sectersion/KernelPanic/reference/trellis_core/assets/pcb_render.png

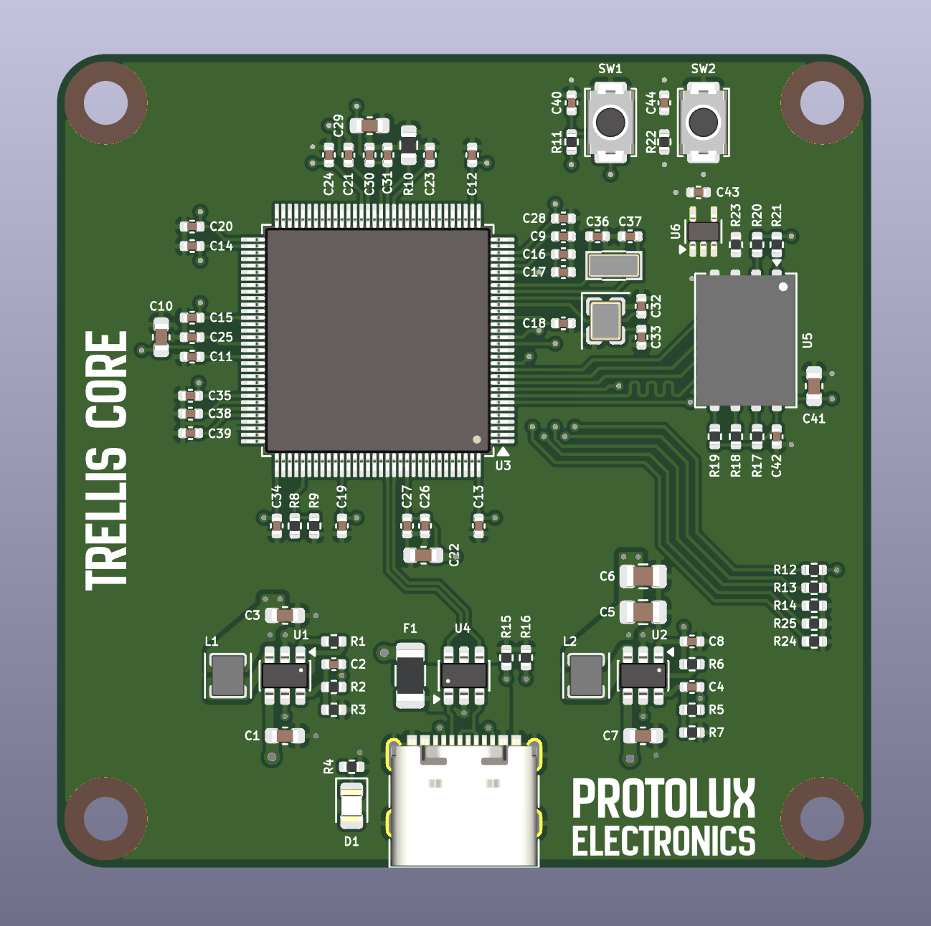
reference/trellis_core/assets/pcb_render.png
