sectersion/KernelPanic/reference/trellis_core/3dmodels/LGA8.step

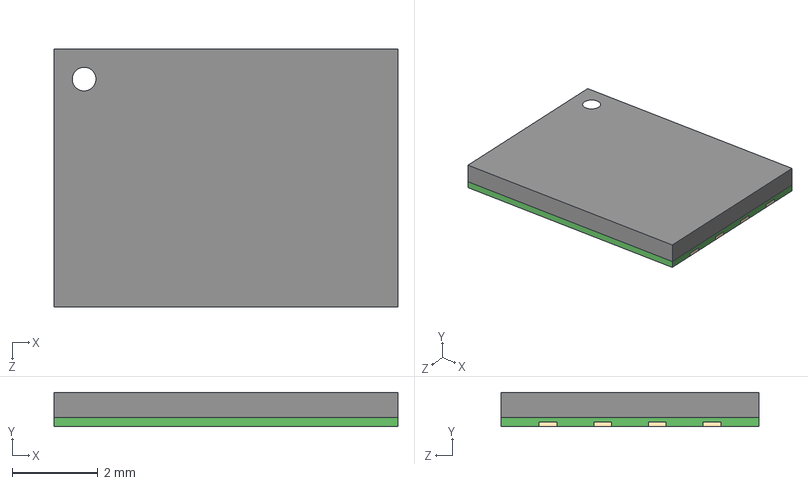
[picture p3: CAD file, 2026-10-30]
reference/trellis_core/3dmodels/LGA8.step
8.00 x 0.8 x 6.00 mm
