sectersion/KernelPanic/reference/trellis_core/src/trellis_core.kicad_pcb

## KiCad design reference/trellis_core/src/trellis_core.kicad_pcb (2026-10-30)

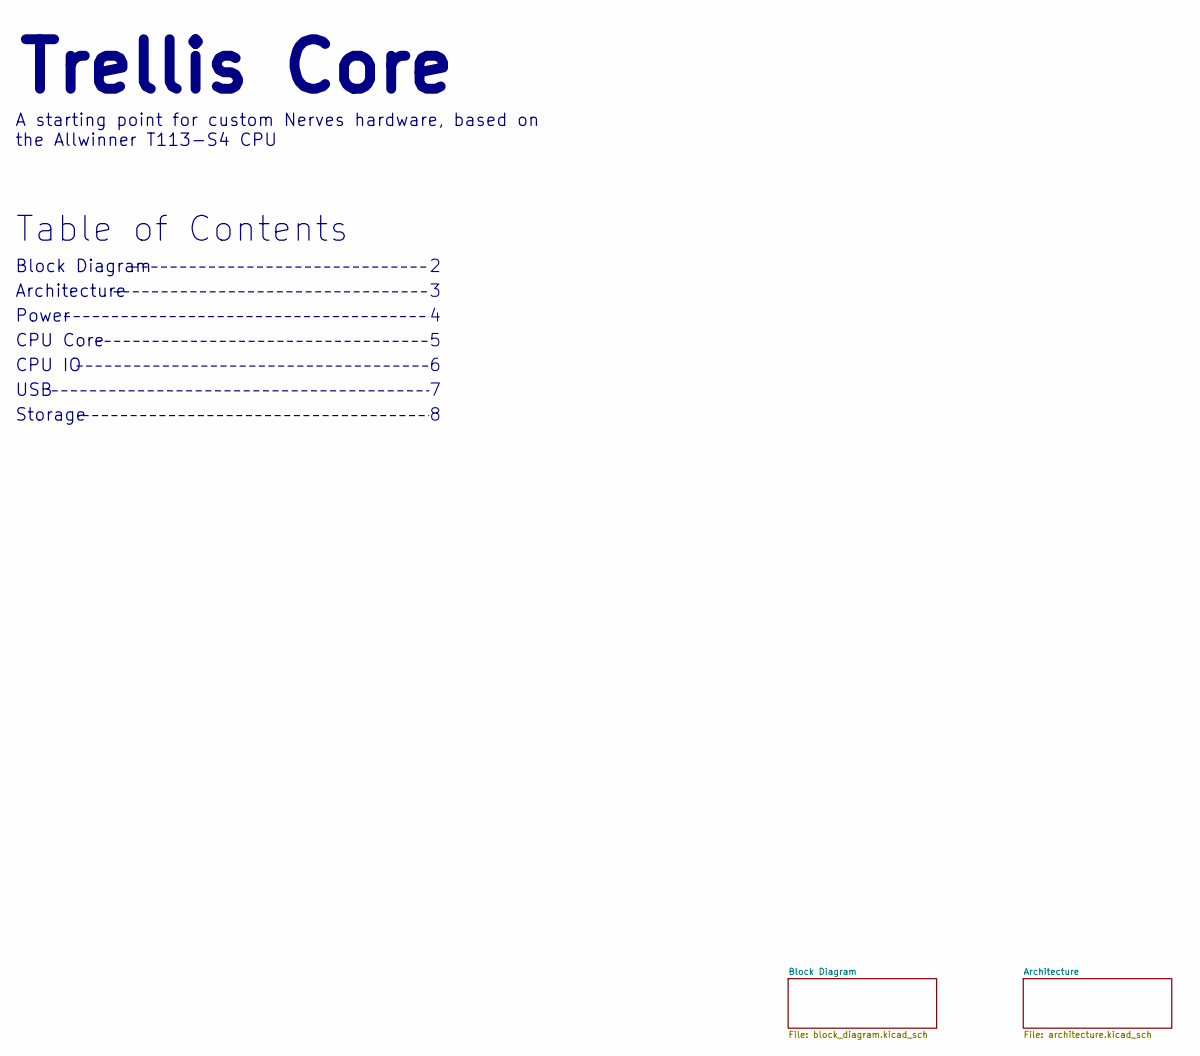
[picture p4: schematic trellis_core.kicad_sch, Trellis Core]

Notes on the sheet:
Table of Contents
Trellis Core
A starting point for custom Nerves hardware, based on the Allwinner T113-S4 CPU
Block Diagram
Architecture
CPU IO
Storage
Power
CPU Core
USB

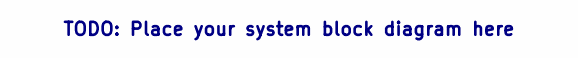
[picture p5: schematic block_diagram.kicad_sch, Trellis Core]

Notes on the sheet:
TODO: Place your system block diagram here

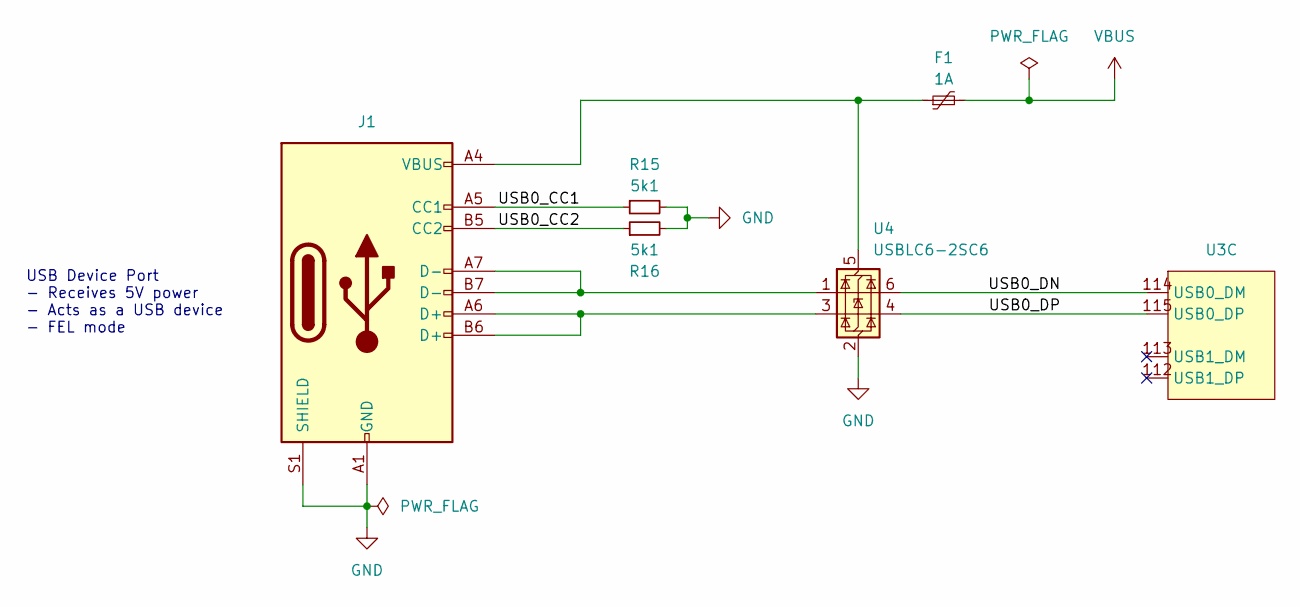
[picture p6: schematic usb.kicad_sch, Trellis Core]

Parts:
F1: 1A; Fuse_1206_3216Metric; MPN JK-nSMD100-16; LCSC C369161
J1: USB_C_Receptacle_USB2.0_14P; USB_C_Receptacle_G-Switch_GT-USB-7010ASV; MPN HX TYPE-C 16P L8.35; LCSC C41427493
R15, R16: 5k1; R_0402_1005Metric; MPN 0402WGF5101TCE; LCSC C25905
U3: T113-S3; T113-S4; MPN T113M4020DC0; LCSC C41411351
U4: USBLC6-2SC6; SOT-23-6; MPN USBLC6-2SC6; LCSC C2827654

Connections:
/Architecture/USB/USB0_CC1: J1.A5 (CC1), R15.1
/Architecture/USB/USB0_CC2: J1.B5 (CC2), R16.1
/Architecture/USB/USB0_DN: U3.114 (USB0_DM), U4.6 (I/O1)
/Architecture/USB/USB0_DP: U3.115 (USB0_DP), U4.4 (I/O2)
GND: J1.A1 (GND), J1.A12 (GND), J1.B1 (GND), J1.B12 (GND), J1.S1 (SHIELD), R15.2, R16.2, U4.2 (GND); also elsewhere on the board
unnamed: J1.A6 (D+), J1.B6 (D+), U4.3 (I/O2)
unnamed: J1.A7 (D-), J1.B7 (D-), U4.1 (I/O1)
unnamed: F1.1, J1.A4 (VBUS), J1.A9 (VBUS), J1.B4 (VBUS), J1.B9 (VBUS), U4.5 (VBUS)
VBUS: F1.2; also elsewhere on the board

Notes on the sheet:
USB Device Port - Receives 5V power - Acts as a USB device - FEL mode

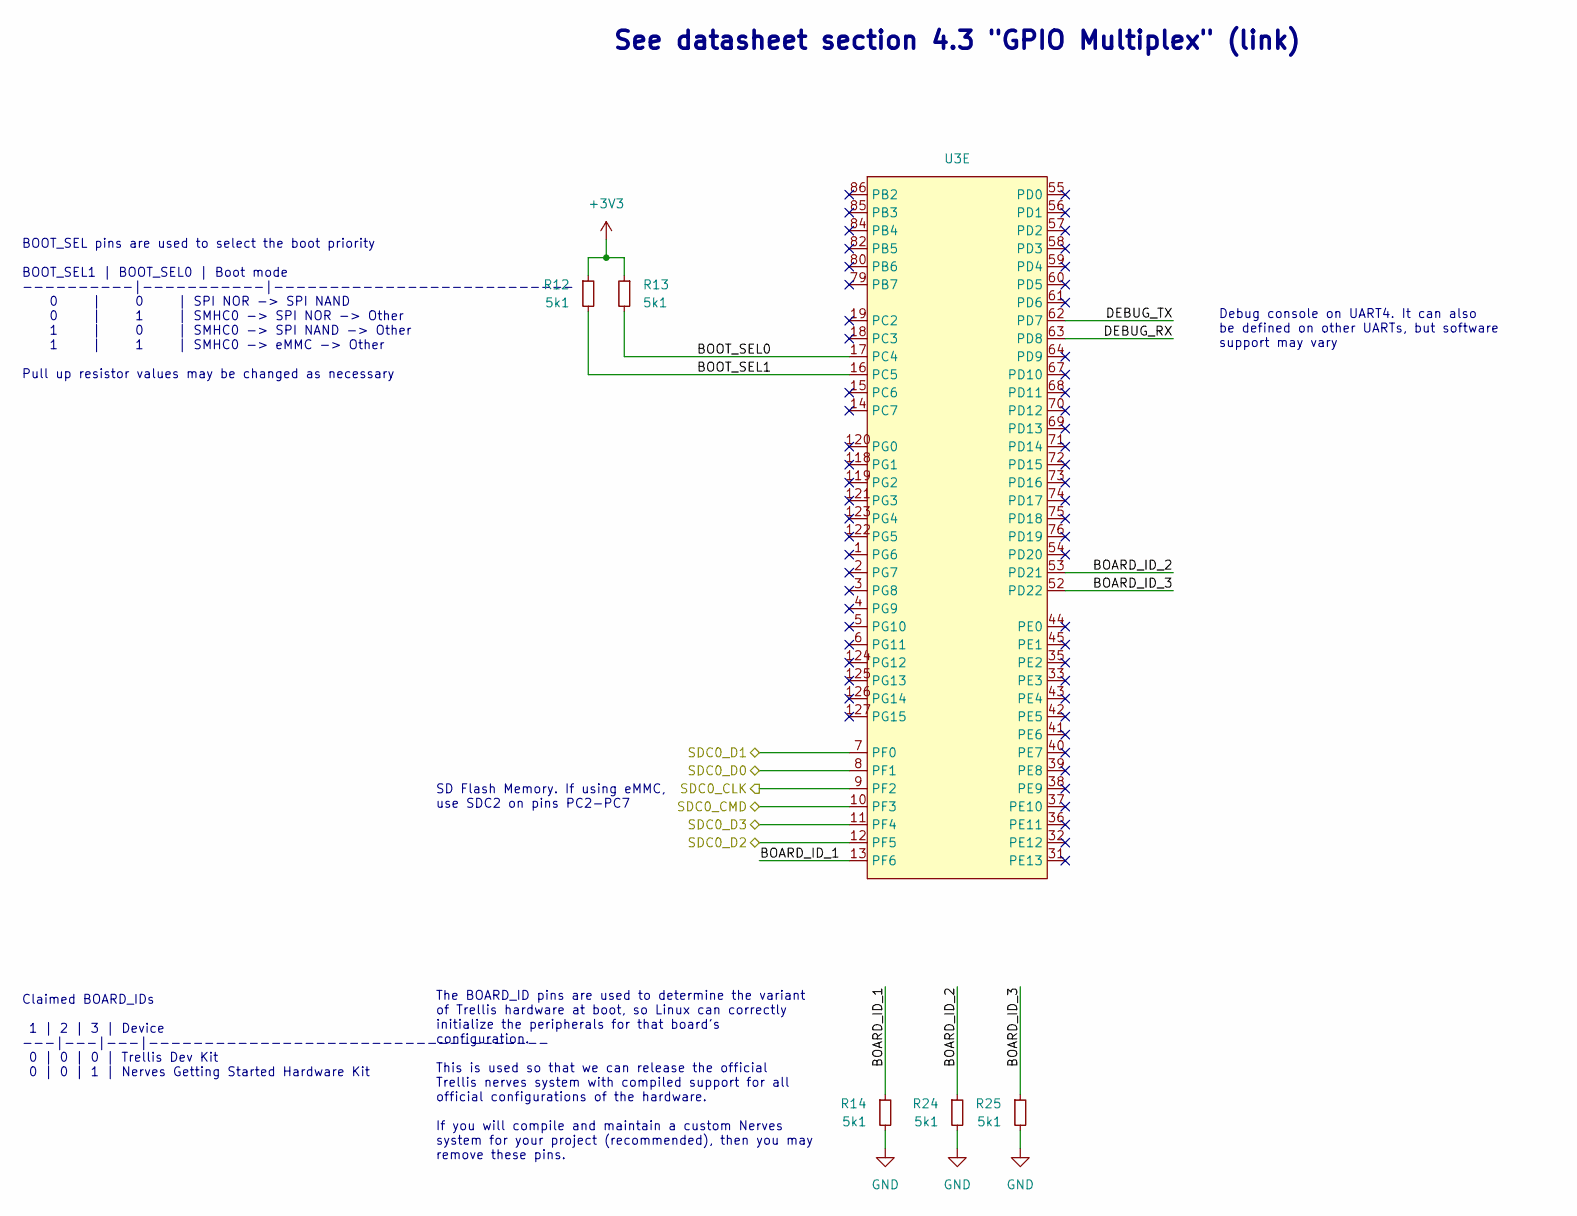
[picture p7: schematic cpu_io.kicad_sch, Trellis Core]

Parts:
R12, R13, R14, R24, R25: 5k1; R_0402_1005Metric; MPN 0402WGF5101TCE; LCSC C25905
U3: T113-S3; MPN T113M4020DC0; LCSC C41411351

Connections:
+3V3: R12.1, R13.1; also elsewhere on the board
/Architecture/CPU IO/BOARD_ID_1: R14.1, U3.13 (PF6)
/Architecture/CPU IO/BOARD_ID_2: R24.1, U3.53 (PD21)
/Architecture/CPU IO/BOARD_ID_3: R25.1, U3.52 (PD22)
/Architecture/CPU IO/BOOT_SEL0: R13.2, U3.17 (PC4)
/Architecture/CPU IO/BOOT_SEL1: R12.2, U3.16 (PC5)
/Architecture/CPU IO/DEBUG_RX: U3.63 (PD8)
/Architecture/CPU IO/DEBUG_TX: U3.62 (PD7)
/Architecture/CPU IO/SDC0_CLK: U3.9 (PF2); also elsewhere on the board
/Architecture/CPU IO/SDC0_CMD: U3.10 (PF3); also elsewhere on the board
/Architecture/CPU IO/SDC0_D0: U3.8 (PF1); also elsewhere on the board
/Architecture/CPU IO/SDC0_D1: U3.7 (PF0); also elsewhere on the board
/Architecture/CPU IO/SDC0_D2: U3.12 (PF5); also elsewhere on the board
/Architecture/CPU IO/SDC0_D3: U3.11 (PF4); also elsewhere on the board
GND: R14.2, R24.2, R25.2; also elsewhere on the board

Notes on the sheet:
The BOARD_ID pins are used to determine the variant of Trellis hardware at boot, so Linux can correctly initialize the peripherals for that board's configuration. This is used so that we can release the official Trellis nerves system with compiled support for all official configurations of the hard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
SD Flash Memory. If using eMMC, use SDC2 on pins PC2-PC7
Debug console on UART4. It can also be defined on other UARTs, but software support may vary
BOOT_SEL pins are used to select the boot priority BOOT_SEL1 | BOOT_SEL0 | Boot mode ----------|-----------|--------------------------- 0 | 0 | SPI NOR -> SPI NAND 0 | 1 | SMHC0 -> SPI NOR -> Other 1 | 0 | SMHC0 -> SPI NAND -> Other 1 | 1 | SMHC0 -> eMMC -> Other Pull up resistor values may be chan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
Claimed BOARD_IDs 1 | 2 | 3 | Device ---|---|---|------------------------------------ 0 | 0 | 0 | Trellis Dev Kit 0 | 0 | 1 | Nerves Getting Started Hardware Kit
See datasheet section 4.3 "GPIO Multiplex" (link)

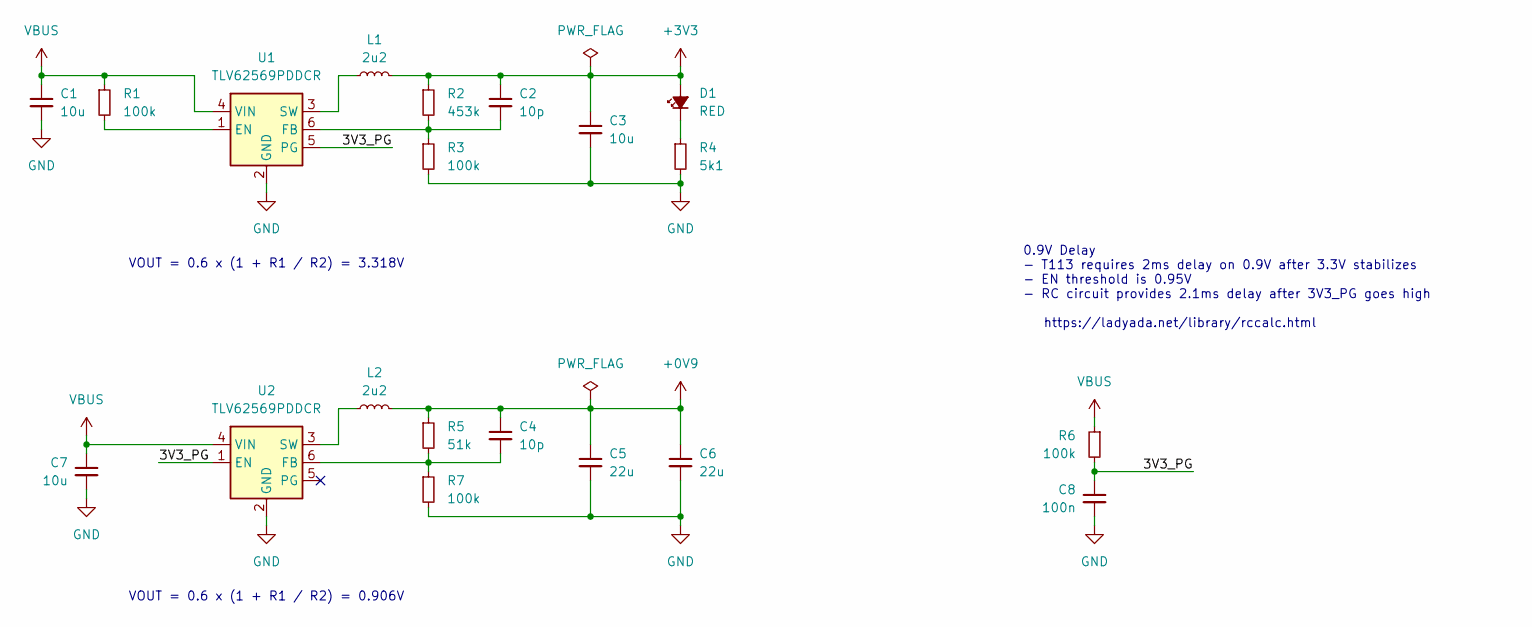
[picture p8: schematic power.kicad_sch, Trellis Core]

Parts:
C1, C3, C7: 10u; C_0603_1608Metric; MPN CL10A106MA8NRNC; LCSC C96446
C2, C4: 10p; C_0402_1005Metric; MPN CL05C100JB5NNNC; LCSC C32949
C5, C6: 22u; C_0805_2012Metric; MPN CL21A226MAQNNNE; LCSC C45783
C8: 100n; C_0402_1005Metric; MPN CL05B104KB54PNC; LCSC C307331
D1: RED; LED_0805_2012Metric; MPN NCD0805R1; LCSC C84256
L1, L2: 2u2; L_Wuerth_MAPI-2510; MPN XRIM252012S2R2MBCA; LCSC C22471111
R1, R3, R6, R7: 100k; R_0402_1005Metric; MPN 0402WGF1003TCE; LCSC C25741
R2: 453k; R_0402_1005Metric; MPN 0402WGF4533TCE; LCSC C27009
R4: 5k1; R_0402_1005Metric; MPN 0402WGF5101TCE; LCSC C25905
R5: 51k; R_0402_1005Metric; MPN 0402WGF5102TCE; LCSC C25794
U1, U2: TLV62569PDDCR; SOT-23-6; MPN TLV62569PDDCR; LCSC C398365

Connections:
+0V9: C4.1, C5.1, C6.1, L2.2, R5.1; also elsewhere on the board
+3V3: C2.1, C3.1, D1.2 (A), L1.2, R2.1; also elsewhere on the board
/Architecture/Power/3V3_PG: C8.1, R6.2, U1.5 (PG), U2.1 (EN)
GND: C1.2, C3.2, C5.2, C6.2, C7.2, C8.2, R3.2, R4.2, R7.2, U1.2 (GND), U2.2 (GND); also elsewhere on the board
unnamed: D1.1 (K), R4.1
unnamed: R1.2, U1.1 (EN)
unnamed: C2.2, R2.2, R3.1, U1.6 (FB)
unnamed: L1.1, U1.3 (SW)
unnamed: C4.2, R5.2, R7.1, U2.6 (FB)
unnamed: L2.1, U2.3 (SW)
VBUS: C1.1, C7.1, R1.1, R6.1, U1.4 (VIN), U2.4 (VIN); also elsewhere on the board

Notes on the sheet:
VOUT = 0.6 x (1 + R1 / R2) = 3.318V
0.9V Delay - T113 requires 2ms delay on 0.9V after 3.3V stabilizes - EN threshold is 0.95V - RC circuit provides 2.1ms delay after 3V3_PG goes high https://ladyada.net/library/rccalc.html
VOUT = 0.6 x (1 + R1 / R2) = 0.906V

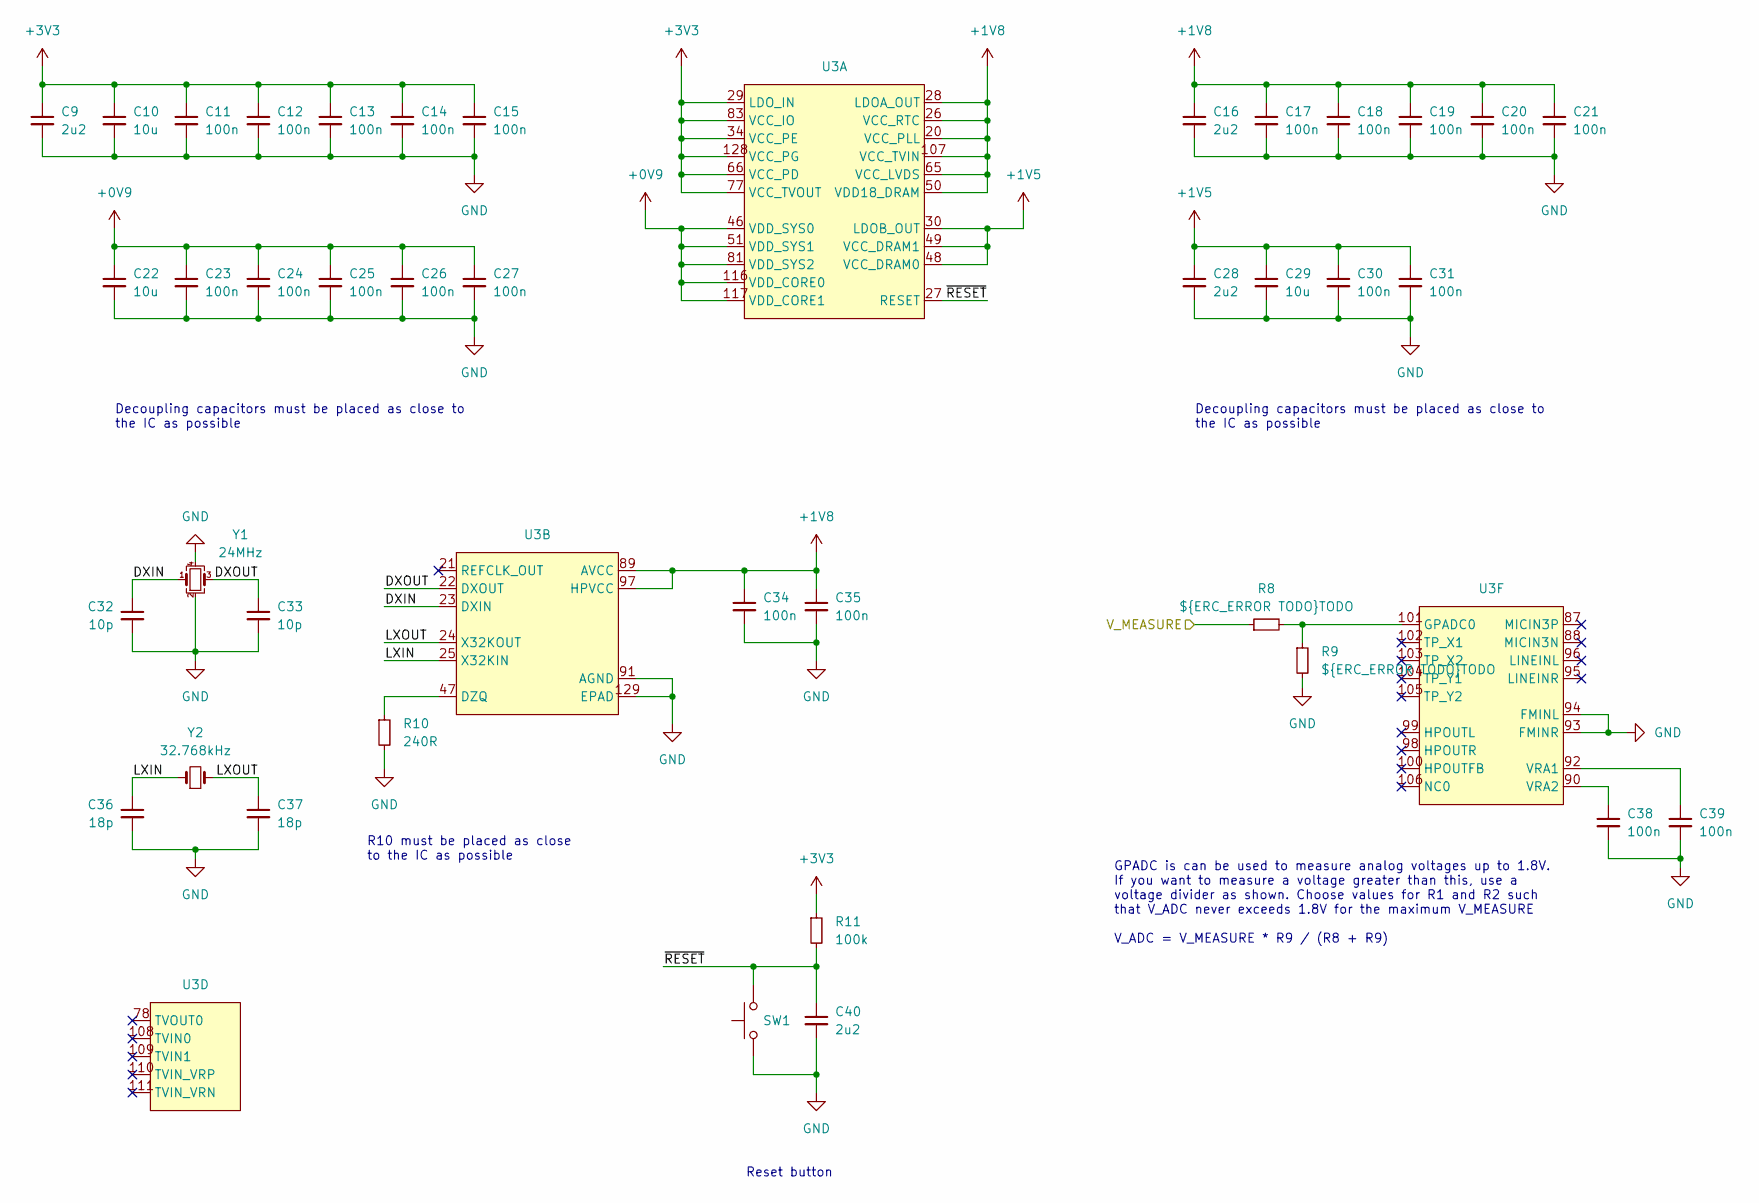
[picture p9: schematic cpu_core.kicad_sch, Trellis Core]

Parts:
C9, C16, C28, C40: 2u2; C_0402_1005Metric; MPN CL05A225MQ5NSNC; LCSC C12530
C10, C22, C29: 10u; C_0603_1608Metric; MPN CL10A106MA8NRNC; LCSC C96446
C11, C12, C13, C14, C15, C17, C18, C19, C20, C21, C23, C24, C25, C26, C27, C30, C31, C34, C35, C38, C39: 100n; C_0402_1005Metric; MPN CL05B104KB54PNC; LCSC C307331
C32, C33: 10p; C_0402_1005Metric; MPN CL05C100JB5NNNC; LCSC C32949
C36, C37: 18p; C_0402_1005Metric; MPN 0402CG180J500NT; LCSC C1549
R8, R9: ${ERC_ERROR TODO}TODO; R_0402_1005Metric
R10: 240R; R_0603_1608Metric; MPN 0603WAF2400T5E; LCSC C23350
R11: 100k; R_0402_1005Metric; MPN 0402WGF1003TCE; LCSC C25741
SW1: SW_Push; SW_Push_SPST_NO_Alps_SKRK; MPN TSA010A2026B; LCSC C2888420
U3: T113-S3; MPN T113M4020DC0; LCSC C41411351
Y1: 24MHz; Crystal_SMD_2520-4Pin_2.5x2.0mm; MPN CM4024M00008001; LCSC C7294624
Y2: 32.768kHz; Crystal_SMD_3215-2Pin_3.2x1.5mm; MPN Q13FC13500004; LCSC C32346

Connections:
+0V9: C22.1, C23.1, C24.1, C25.1, C26.1, C27.1, U3.46 (VDD_SYS0), U3.51 (VDD_SYS1), U3.81 (VDD_SYS2), U3.116 (VDD_CORE0), U3.117 (VDD_CORE1); also elsewhere on the board
+1V5: C28.1, C29.1, C30.1, C31.1, U3.30 (LDOB_OUT), U3.48 (VCC_DRAM0), U3.49 (VCC_DRAM1)
+1V8: C16.1, C17.1, C18.1, C19.1, C20.1, C21.1, C34.1, C35.1, U3.20 (VCC_PLL), U3.26 (VCC_RTC), U3.28 (LDOA_OUT), U3.50 (VDD18_DRAM), U3.65 (VCC_LVDS), U3.89 (AVCC), U3.97 (HPVCC), U3.107 (VCC_TVIN)
+3V3: C9.1, C10.1, C11.1, C12.1, C13.1, C14.1, C15.1, R11.1, U3.29 (LDO_IN), U3.34 (VCC_PE), U3.66 (VCC_PD), U3.77 (VCC_TVOUT), U3.83 (VCC_IO), U3.128 (VCC_PG); also elsewhere on the board
/Architecture/CPU Core/DXIN: C32.1, U3.23 (DXIN), Y1.1
/Architecture/CPU Core/DXOUT: C33.1, U3.22 (DXOUT), Y1.3
/Architecture/CPU Core/LXIN: C36.1, U3.25 (X32KIN), Y2.1
/Architecture/CPU Core/LXOUT: C37.1, U3.24 (X32KOUT), Y2.2
/Architecture/CPU Core/V_MEASURE: R8.1
/Architecture/CPU Core/~RESET: C40.1, R11.2, SW1.2, U3.27 (RESET)
GND: C9.2, C10.2, C11.2, C12.2, C13.2, C14.2, C15.2, C16.2, C17.2, C18.2, C19.2, C20.2, C21.2, C22.2, C23.2, C24.2, C25.2, C26.2, C27.2, C28.2, C29.2, C30.2, C31.2, C32.2, C33.2, C34.2, C35.2, C36.2, C37.2, C38.2, C39.2, C40.2, R9.2, R10.2, SW1.1, U3.91 (AGND), U3.93 (FMINR), U3.94 (FMINL), U3.129 (EPAD), Y1.2, Y1.4; also elsewhere on the board
unnamed: R10.1, U3.47 (DZQ)
unnamed: R8.2, R9.1, U3.101 (GPADC0)
unnamed: C39.1, U3.92 (VRA1)
unnamed: C38.1, U3.90 (VRA2)

Notes on the sheet:
Reset button
Decoupling capacitors must be placed as close to the IC as possible
GPADC is can be used to measure analog voltages up to 1.8V. If you want to measure a voltage greater than this, use a voltage divider as shown. Choose values for R1 and R2 such that V_ADC never exceeds 1.8V for the maximum V_MEASURE V_ADC = V_MEASURE * R9 / (R8 + R9)
R10 must be placed as close to the IC as possible

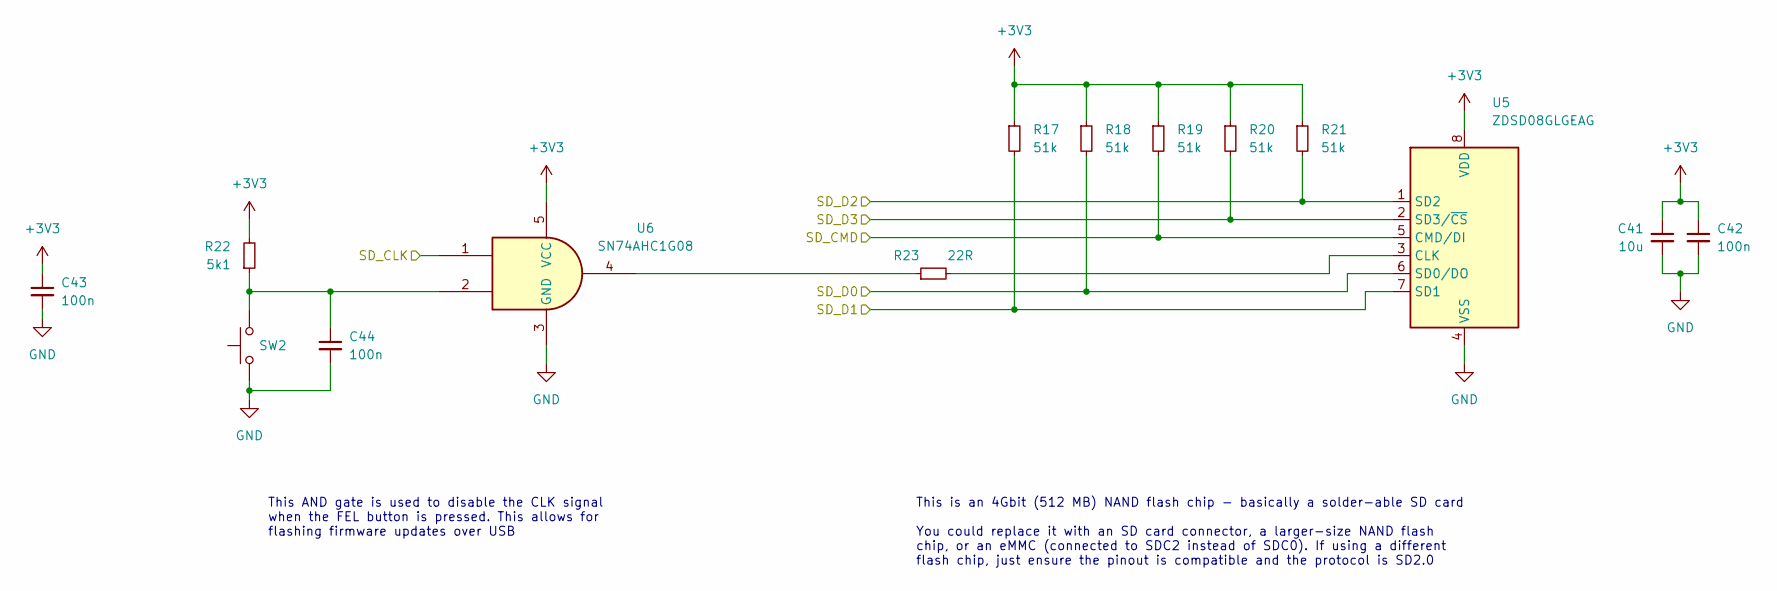
[picture p10: schematic storage.kicad_sch, Trellis Core]

Parts:
C41: 10u; C_0603_1608Metric; MPN CL10A106MA8NRNC; LCSC C96446
C42, C43, C44: 100n; C_0402_1005Metric; MPN CL05B104KB54PNC; LCSC C307331
R17, R18, R19, R20, R21: 51k; R_0402_1005Metric; MPN 0402WGF5102TCE; LCSC C25794
R22: 5k1; R_0402_1005Metric; MPN 0402WGF5101TCE; LCSC C25905
R23: 22R; R_0402_1005Metric; MPN 0402WGF220JTCE; LCSC C25092
SW2: SW_Push; SW_Push_SPST_NO_Alps_SKRK; MPN TSA010A2026B; LCSC C2888420
U5: ZDSD08GLGEAG; LGA-8_8x6mm_P1.27mm; MPN ZDSD04GLGEAG; LCSC C2875854
U6: SN74AHC1G08; Texas_R-PDSO-G5_DCK-5; MPN SN74AHC1G08DCKR; LCSC C122838

Connections:
+3V3: C41.1, C42.1, C43.1, R17.1, R18.1, R19.1, R20.1, R21.1, R22.2, U5.8 (VDD), U6.5 (VCC); also elsewhere on the board
/Architecture/CPU IO/SDC0_CLK: U6.1; also elsewhere on the board
/Architecture/CPU IO/SDC0_CMD: R19.2, U5.5 (CMD/DI); also elsewhere on the board
/Architecture/CPU IO/SDC0_D0: R18.2, U5.6 (SD0/DO); also elsewhere on the board
/Architecture/CPU IO/SDC0_D1: R17.2, U5.7 (SD1); also elsewhere on the board
/Architecture/CPU IO/SDC0_D2: R21.2, U5.1 (SD2); also elsewhere on the board
/Architecture/CPU IO/SDC0_D3: R20.2, U5.2 (SD3/~CS); also elsewhere on the board
GND: C41.2, C42.2, C43.2, C44.2, SW2.1, U5.4 (VSS), U6.3 (GND); also elsewhere on the board
unnamed: C44.1, R22.1, SW2.2, U6.2
unnamed: R23.1, U6.4
unnamed: R23.2, U5.3 (CLK)

Notes on the sheet:
This is an 4Gbit (512 MB) NAND flash chip - basically a solder-able SD card You could replace it with an SD card connector, a larger-size NAND flash chip, or an eMMC (connected to SDC2 instead of SDC0). If using a different flash chip, just ensure the pinout is compatible and the protocol is SD2.0
This AND gate is used to disable the CLK signal when the FEL button is pressed. This allows for flashing firmware updates over USB

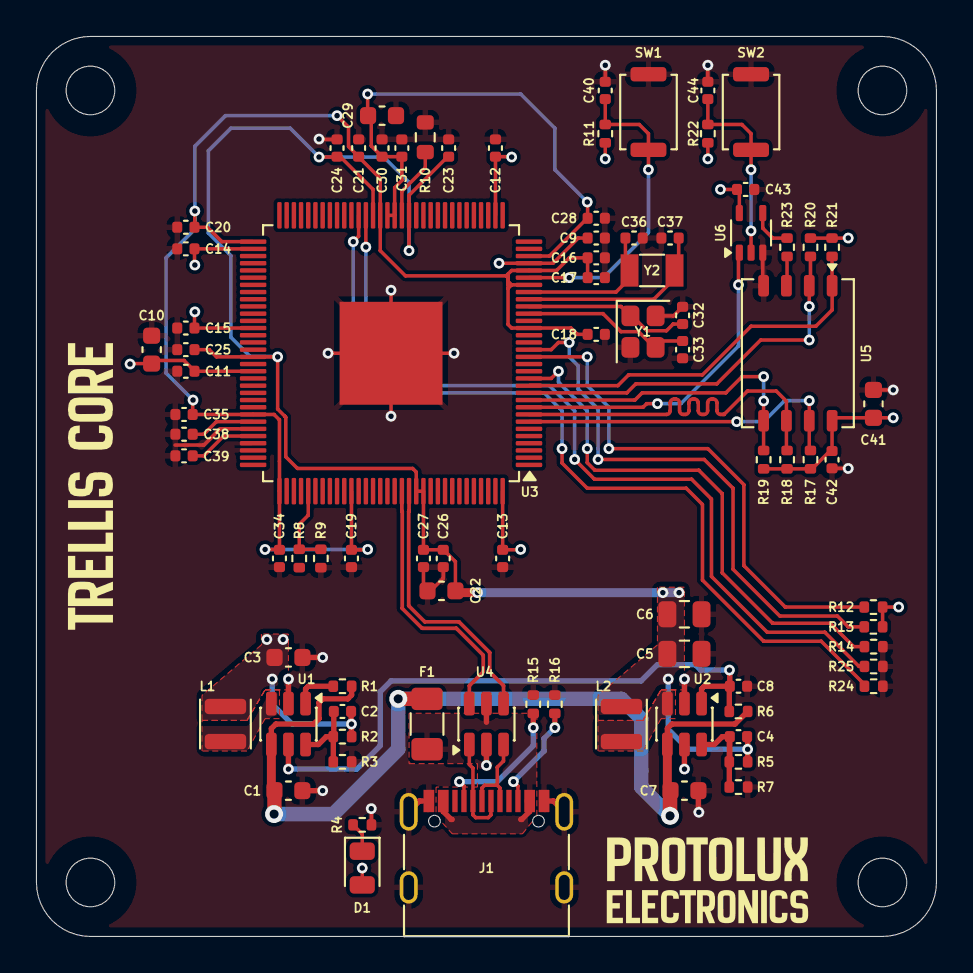
[picture p11: board trellis_core.kicad_pcb from above]

Board: 4 copper layers, 50.0 x 50.0 mm, 89 parts (0 on the bottom side), 43 nets.

Other parts of the board:
H1, H2, H3, H4: MountingHole_2.7mm_M2.5_DIN965
kibuzzard-68FD2BE5: G***; kibuzzard-68FD2BE5
