sectersion/KernelPanic/(commit log)

2026-11-01 Update schematic, project, notes, libs and datasheets
    [KernelPanic.kicad_sch]
2026-11-03 finish power
    [KernelPanic.kicad_sch, ethernet.kicad_sch, power.kicad_sch]
