sectersion/KernelPanic/(notices)

Notices in the files:
reference/trellis_core/src/storage.kicad_sch:
Licensed under CERN-OHL-P version 2
Copyright 2025 Protolux Electronics
